wapjin/xiudaiapis/files/注液腔切孔工装.STEP

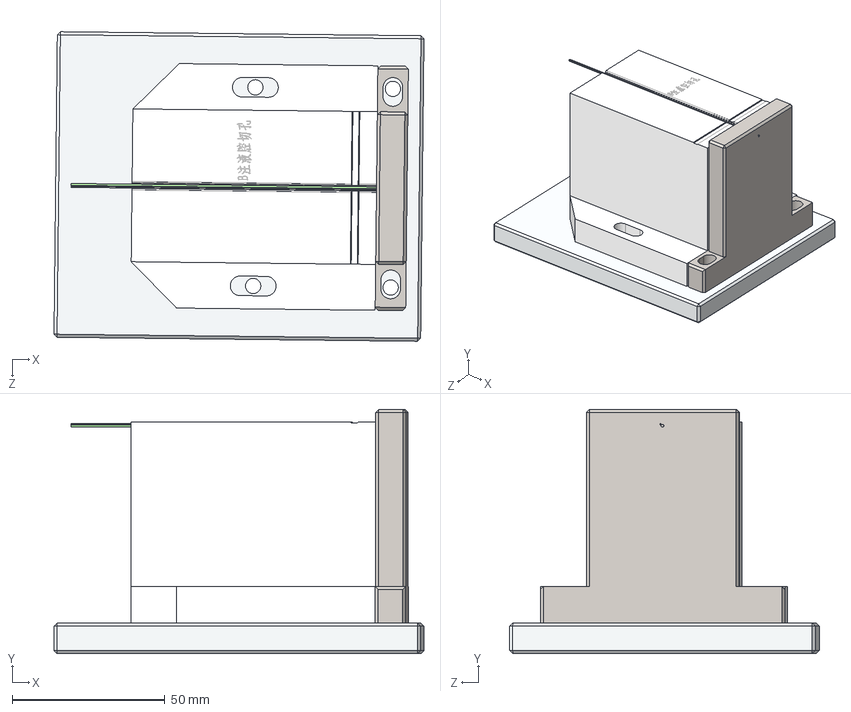
[picture p1: CAD file, 2021-09-23, last stored version]
files/注液腔切孔工装.STEP
121.1 x 80.0 x 101.3 mm
注液腔左侧板
注液腔切孔右侧板
ﾗ｢ﾒｺﾇｻﾇﾐｿﾗ0.35ﾖｧｳﾅﾋｿ
ﾗ｢ﾒｺﾇｻﾇﾐｿﾗ0.89ﾖｧｳﾅﾋｿ
蛁珘У菁釱
