wapjin/xiudaiapis/files/电烙铁头.STEP

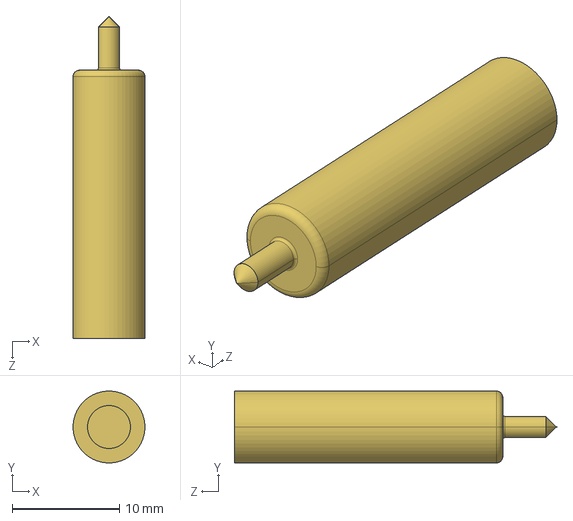
[picture p2: CAD file, 2021-09-23, last stored version]
files/电烙铁头.STEP
6.70 x 6.70 x 30.0 mm
