wapjin/xiudaiapis/files/囊体固定隔板.STEP

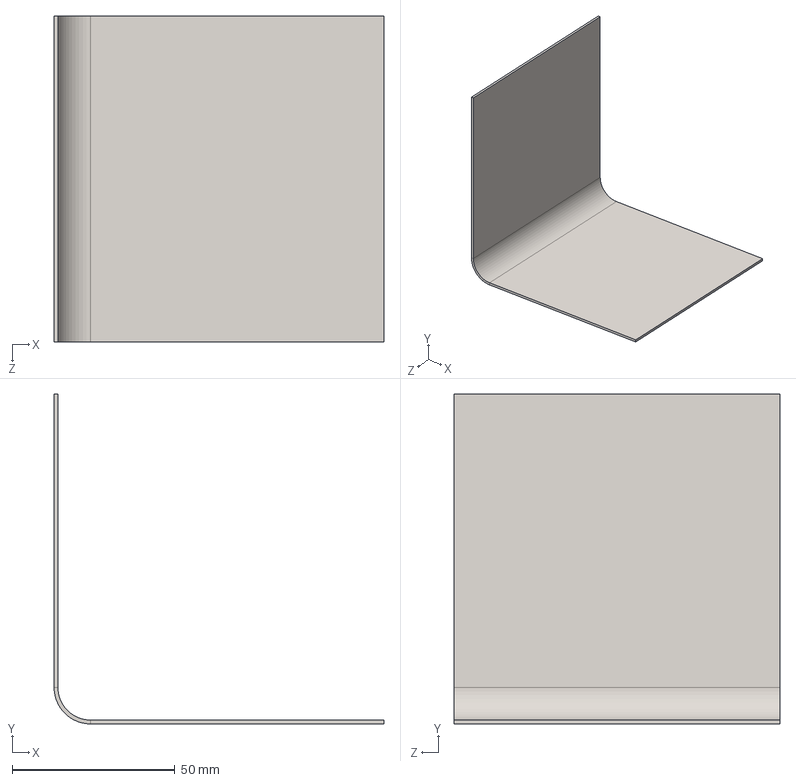
[picture p4: CAD file, 2021-09-23, last stored version]
files/囊体固定隔板.STEP
101.2 x 101.2 x 100.0 mm
