wapjin/xiudaiapis/files/15mm球囊-定尺工装总装.STEP

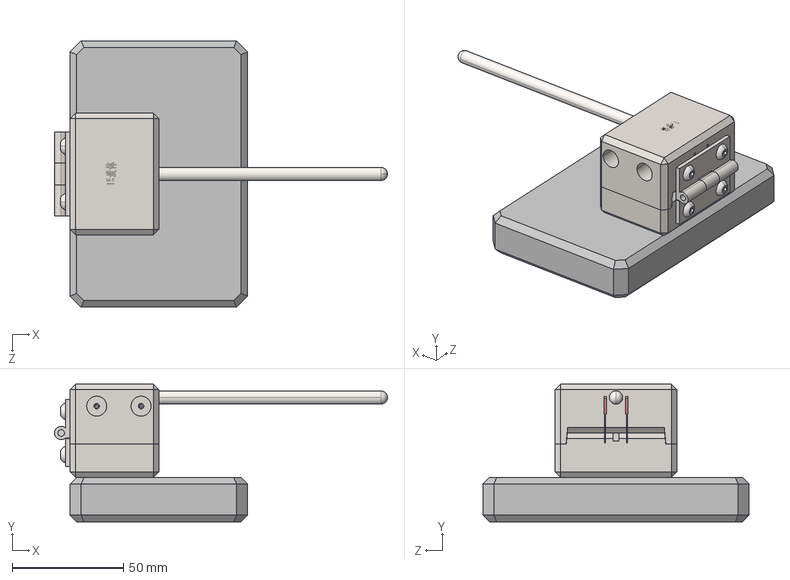
[picture p5: CAD file, 2021-09-23, last stored version]
files/15mm球囊-定尺工装总装.STEP
150.0 x 62.0 x 120.0 mm
菁啣
15mm球囊-下板
15mm球囊-上板
忒梟
磁珜1
磁珜2
磁珜种粣
絮え x 2
hex socket set screws with flat point gb_GB_FASTENER_SCREWS_HSFP M3X5-S x 4
hexagon socket button head screws gb_GB_SOCKET_TYPE7 M4X8-S x 4
hexagon socket head cap screws gb_PreviewCfg x 2
