wapjin/xiudaiapis/files/显影环夹钳.STEP

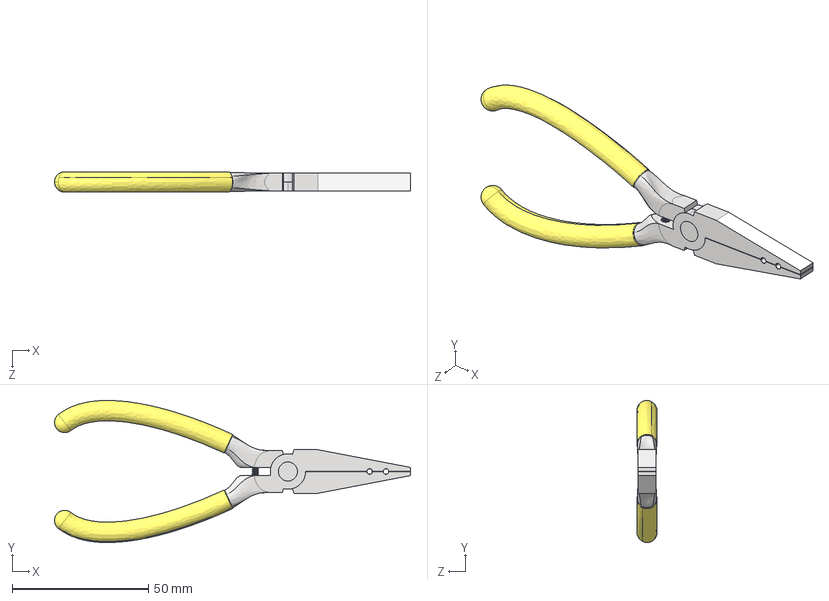
[picture p6: CAD file, 2021-09-23, last stored version]
files/显影环夹钳.STEP
130.8 x 52.2 x 7.50 mm
