wapjin/xiudaiapis/(list of files, cad)

Other CAD files:
files/囊体固定隔板.SLDPRT
